omahonye/measuring-wave-forces-on-lighthouses/docs/README.md

# Documentation

This folder contains the supporting thesis, and engineering drawings for the project.

## Contents

| File | Description |
|---|---|
| `Thesis_EoghanOMahony_25230268-1.pdf` | Master's thesis describing the design, development, implementation, and validation of the experimental wave impact measurement system. |
| `01 Accelerometer Holder.pdf` | Engineering drawing of the accelerometer holder used for sensor mounting. |
| `02 Lighthouse Base Drawing.pdf` | Engineering drawing of the lighthouse base section. |
| `03 Fastnet Whole.pdf` | Complete engineering drawing of the Fastnet lighthouse model. |
| `04 Skerryvore Base Drawing.pdf` | Engineering drawing of the Skerryvore lighthouse base section. |
| `05 Skerryvore Upper Drawing.pdf` | Engineering drawing of the Skerryvore upper section. |
| `06 Ar Men Base Drawing.pdf` | Engineering drawing of the Ar Men lighthouse base section. |
| `07 Ar Men Upper Drawing.pdf` | Engineering drawing of the Ar Men upper section. |
| `08 Wolf Rock Base Drawing.pdf` | Engineering drawing of the Wolf Rock lighthouse base section. |
| `09 Wolf Rock Upper Drawing.pdf` | Engineering drawing of the Wolf Rock upper section. |

## Thesis

The thesis provides a comprehensive description of the project, including:

- Background and literature review
- System design and hardware development
- Embedded software implementation
- Python data acquisition and processing tools
- Experimental methodology
- Calibration procedures
- Results and discussion
- Conclusions and recommendations for future work

The source code, embedded firmware, and engineering drawings contained in this repository were developed as part of the work presented in the accompanying thesis.

## Engineering Drawings

The included engineering drawings document the design and manufacture of the experimental components, including:

- Accelerometer mounting hardware
- Lighthouse geometry
- Base and upper sections for:
  - Fastnet
  - Skerryvore
  - Ar Men
  - Wolf Rock

These drawings provide the dimensions and construction details required to reproduce the physical sections used during experimental validation.

## Citation

If you use or reference this work, please cite the accompanying thesis.

## Contact

For questions regarding the project, engineering drawings, or thesis, please contact the repository author through GitHub.
