omahonye/measuring-wave-forces-on-lighthouses/docs/01 Accelerometer Holder.pdf

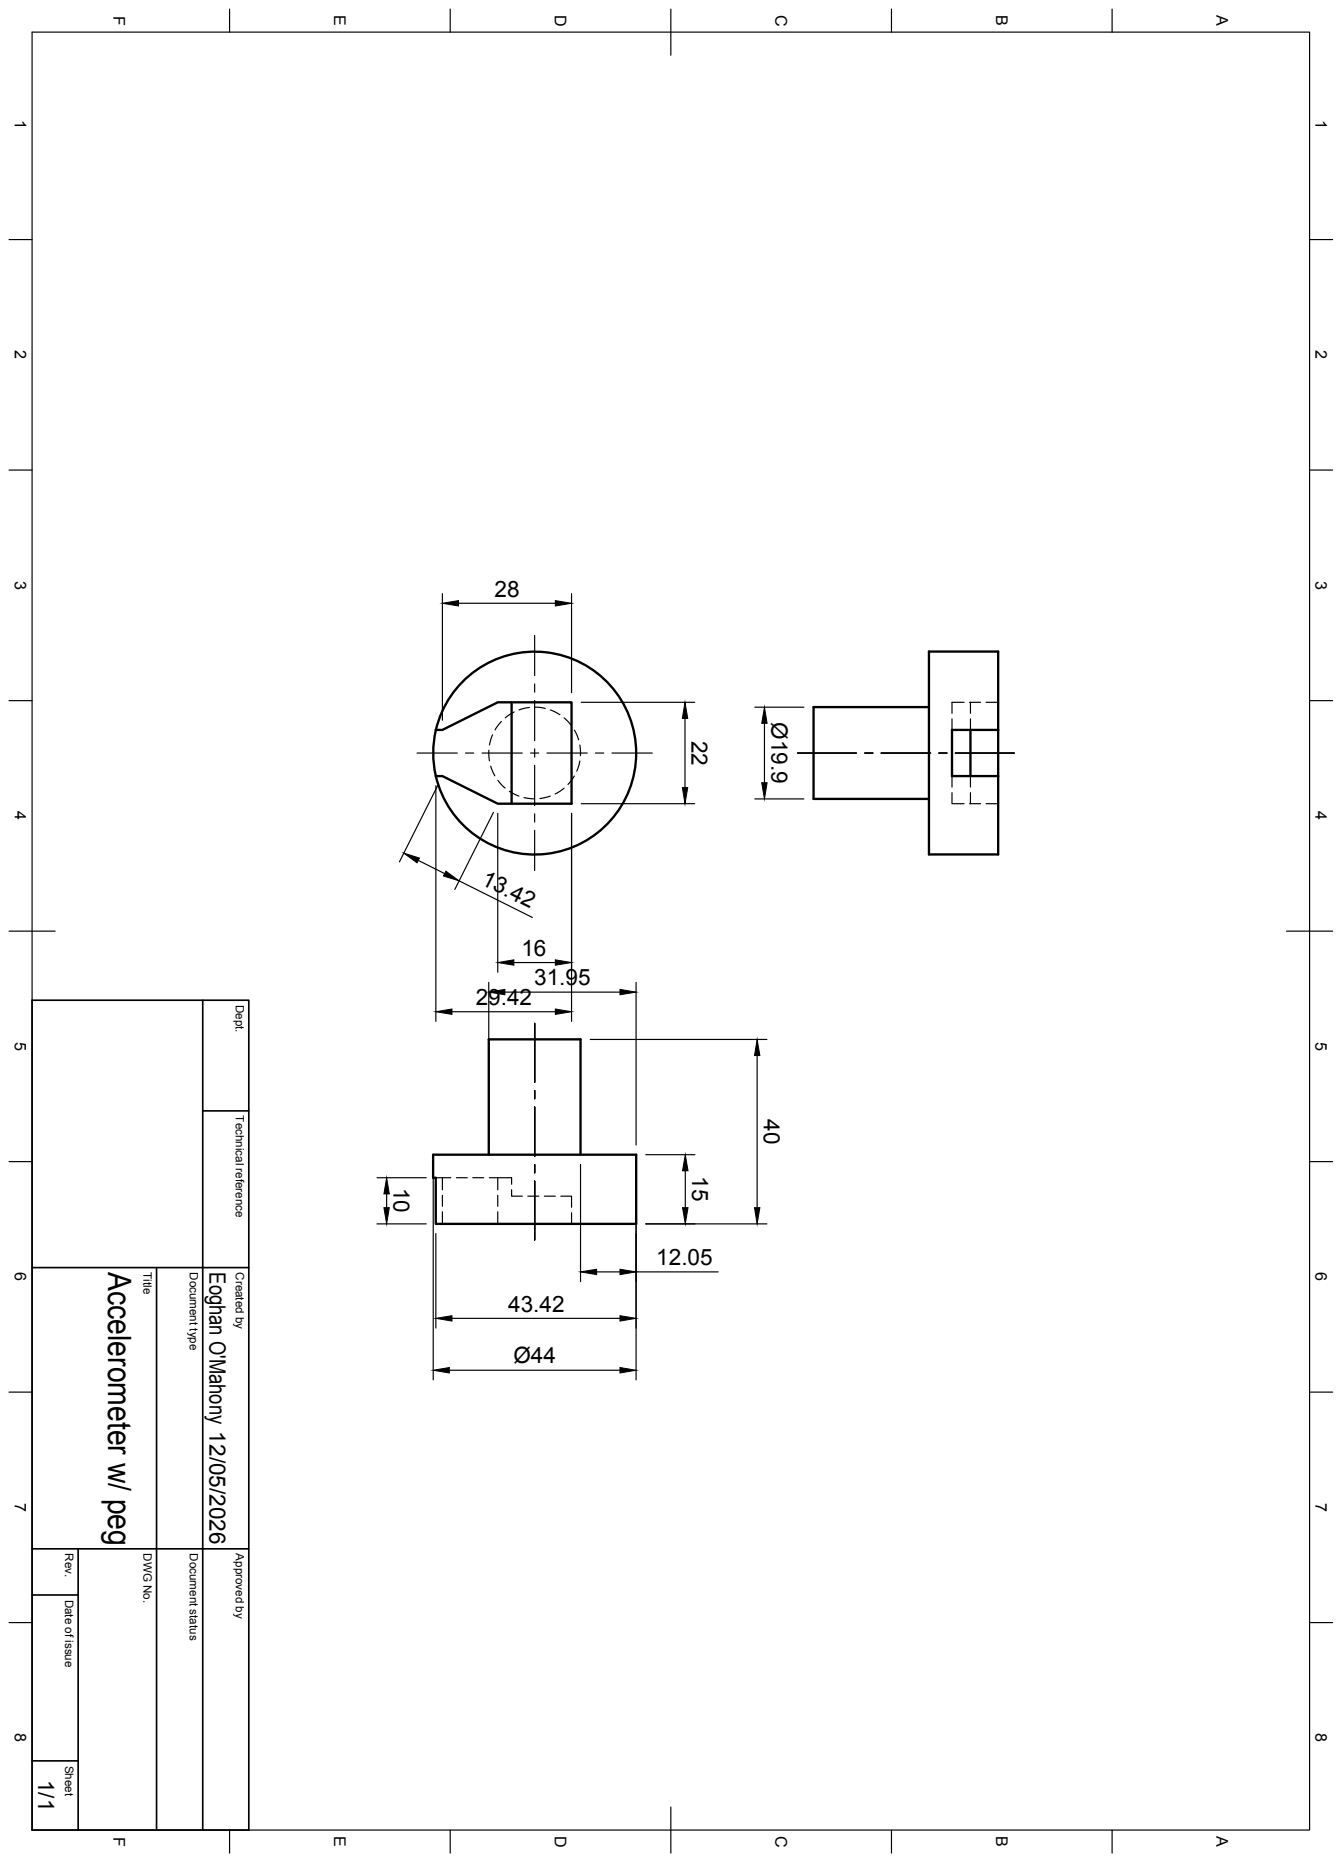
[picture p1: page 1]
DWG No.; Accelerometer w/ peg; Eoghan O'Mahony

Dept. Technical reference Created by Approved by

Document type Document status

Date of issue Sheet
