omahonye/measuring-wave-forces-on-lighthouses/docs/02 Lighthouse Base Drawing.pdf

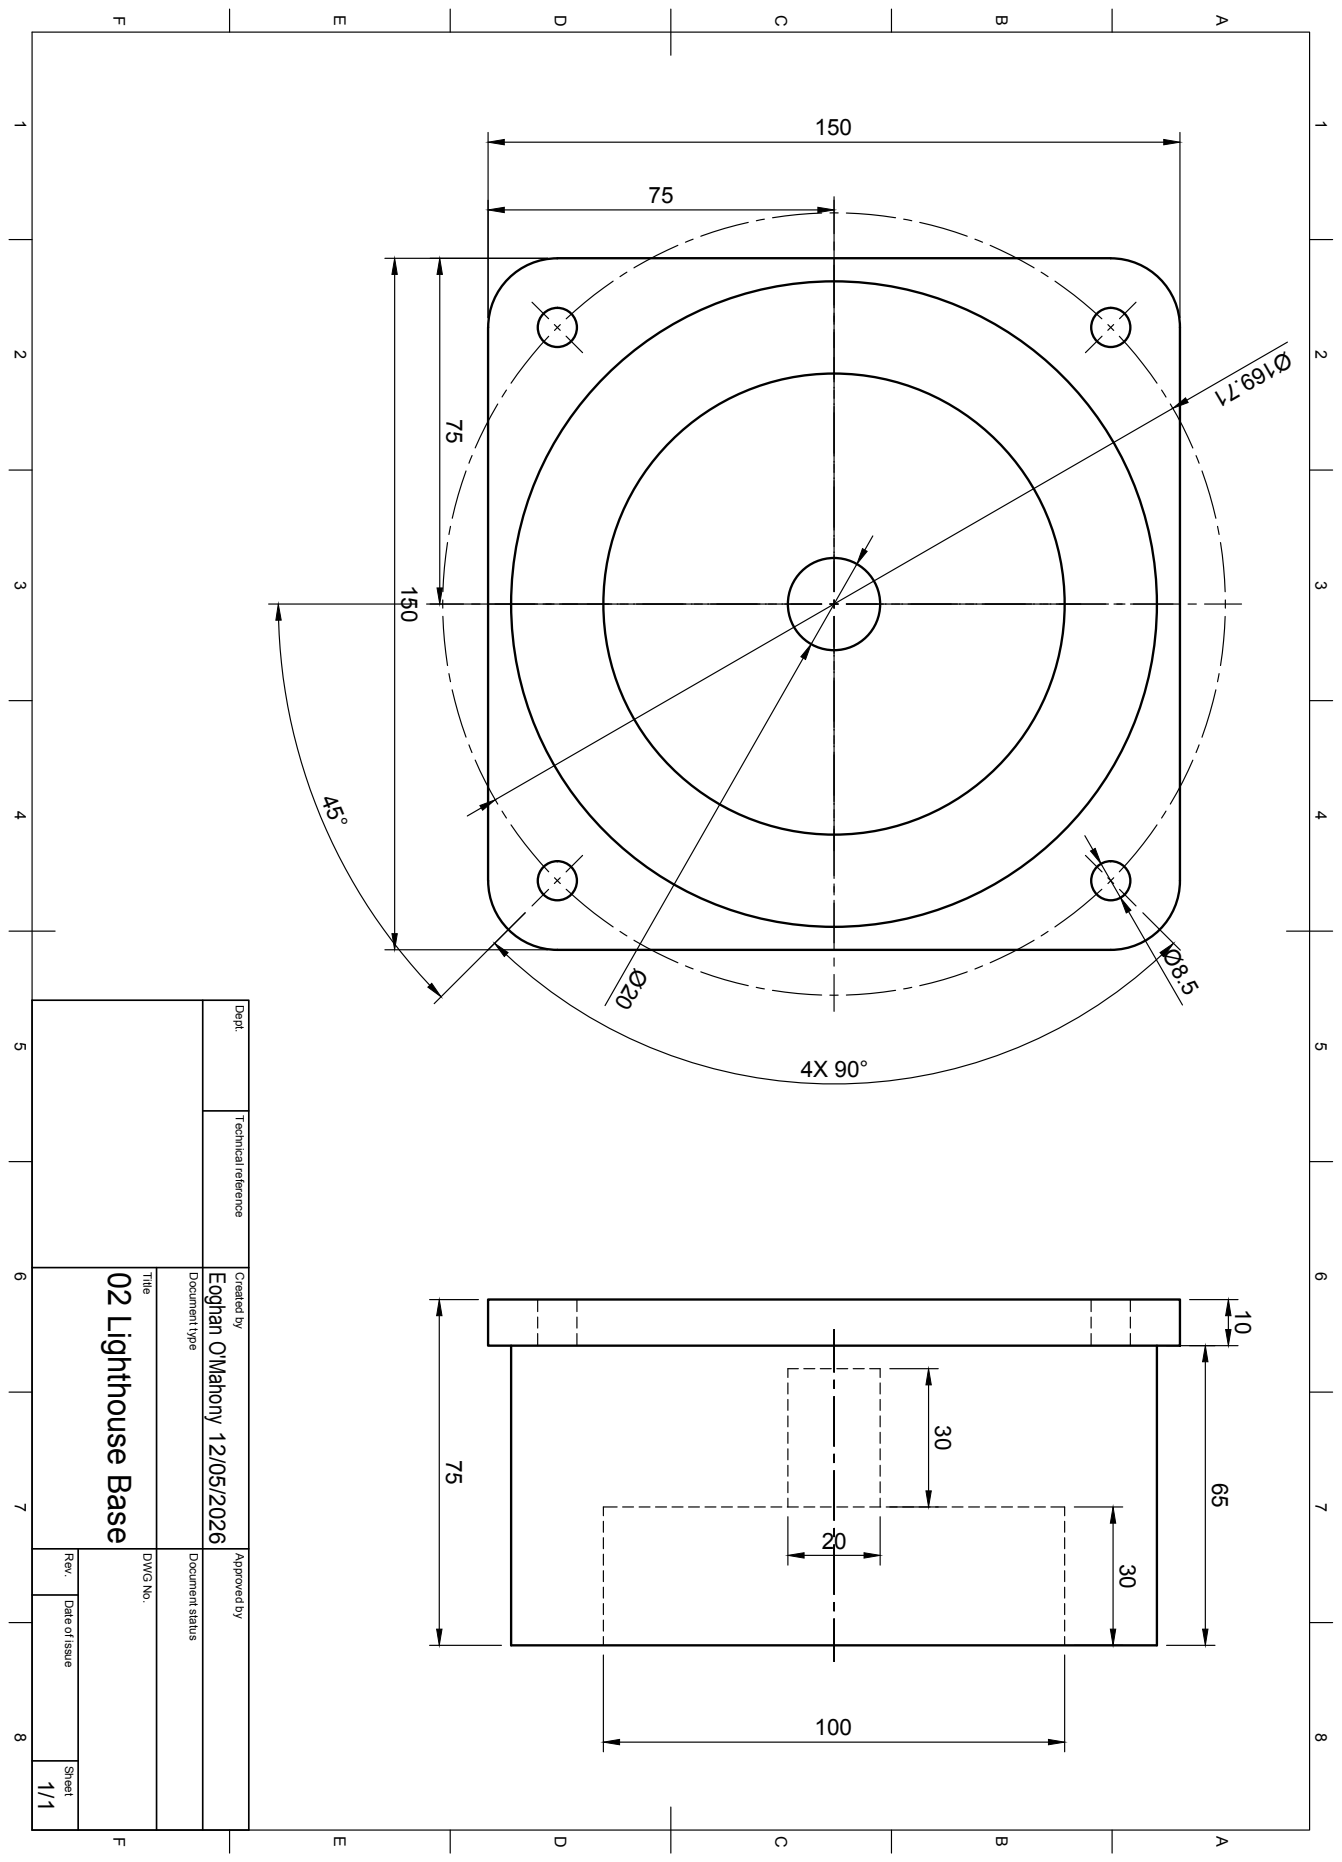
[picture p2: page 1]
DWG No.; 02 Lighthouse Base; Eoghan O'Mahony 150

Dept. Technical reference Created by Approved by

Document type Document status

Date of issue Sheet
