omahonye/measuring-wave-forces-on-lighthouses/docs/03 Fastnet Whole.pdf

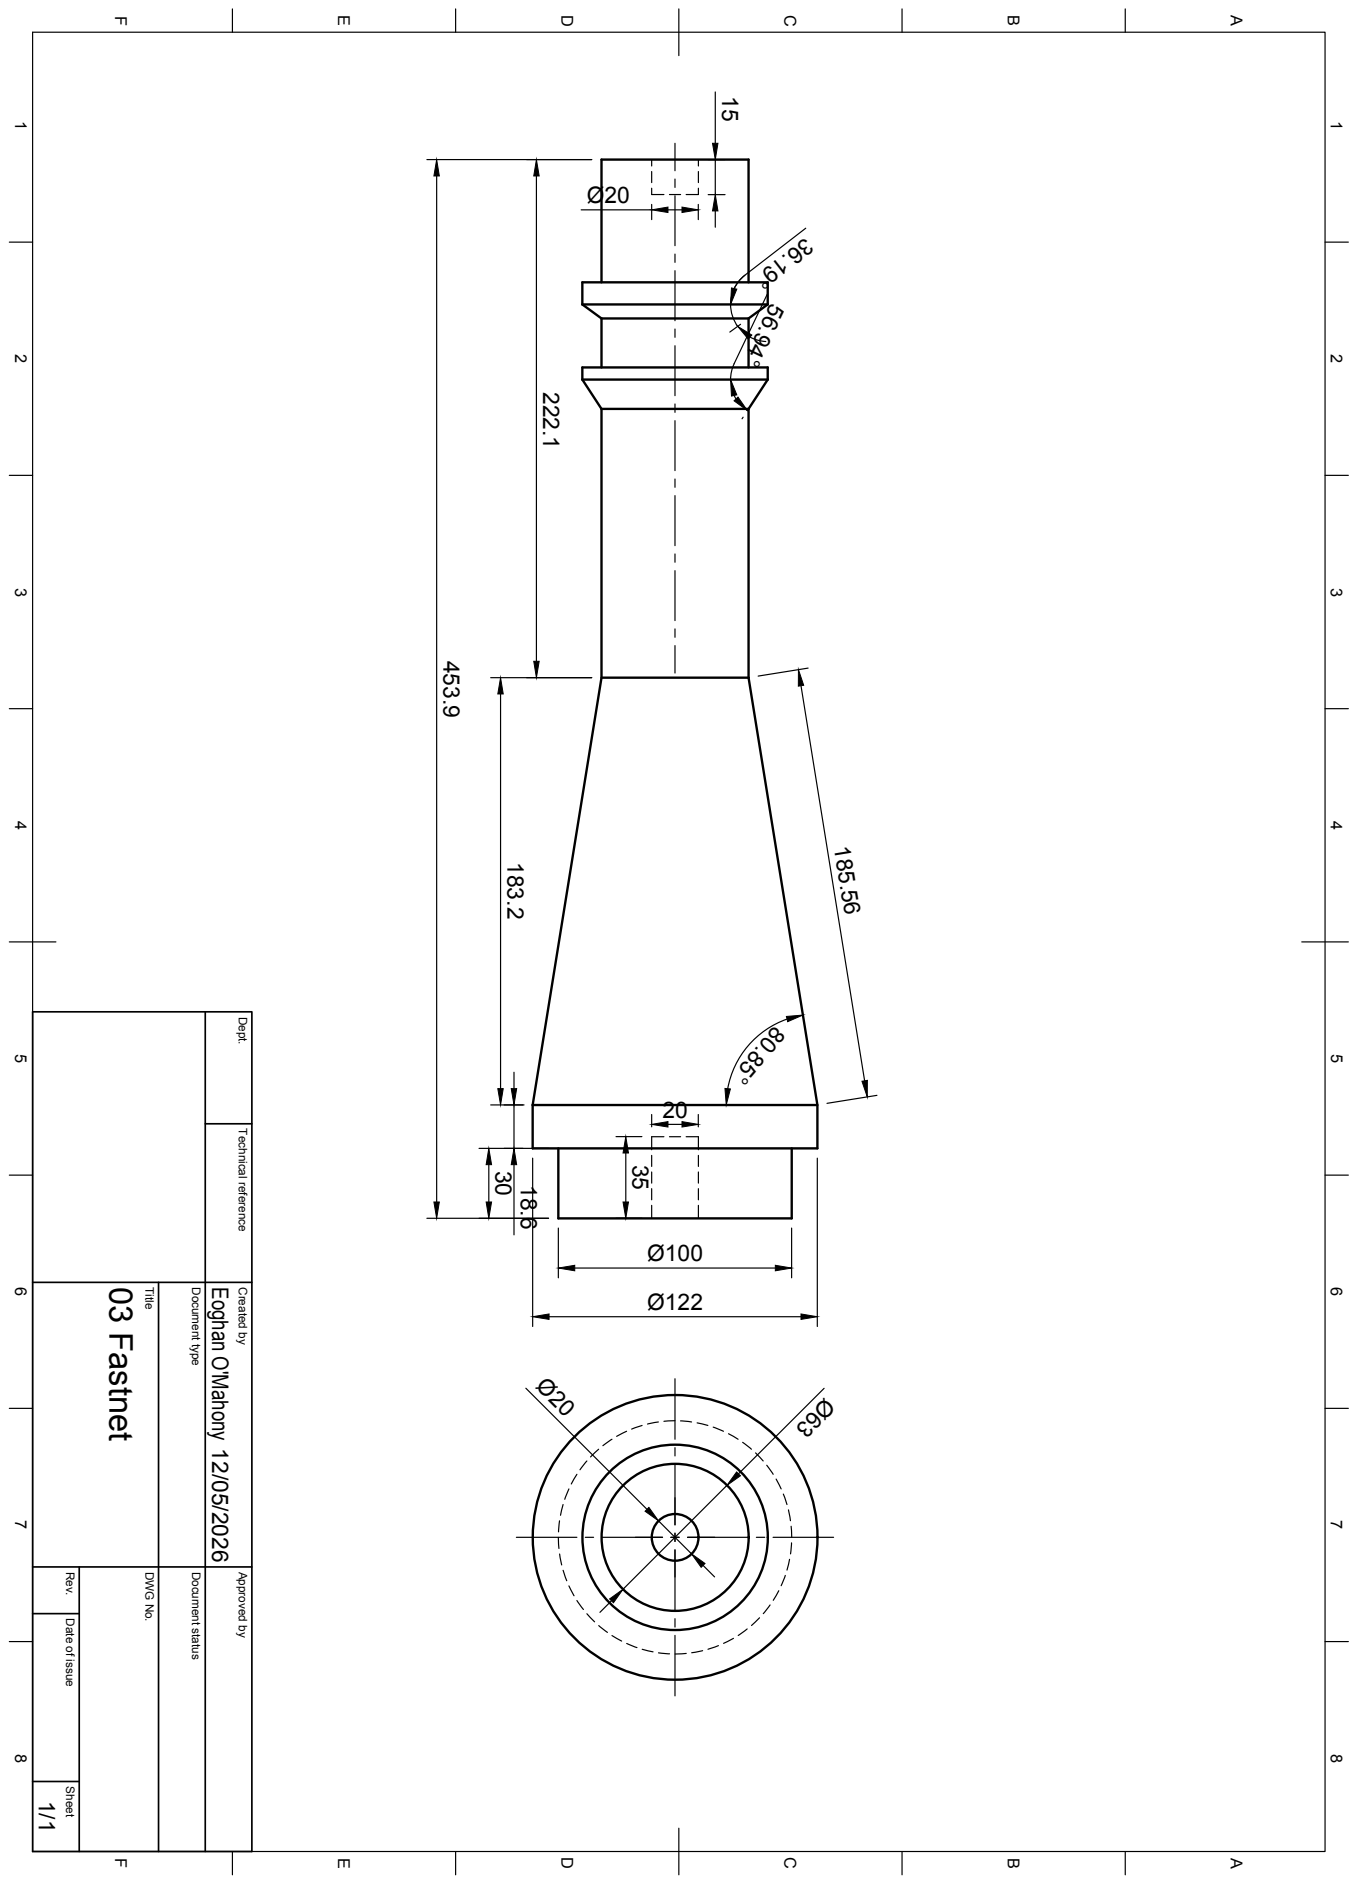
[picture p3: page 1]
DWG No.; 03 Fastnet; Eoghan O'Mahony Ø122

Dept. Technical reference Created by Approved by

Document type Document status

Date of issue Sheet
