omahonye/measuring-wave-forces-on-lighthouses/docs/04 Skerryvore Base Drawing.pdf

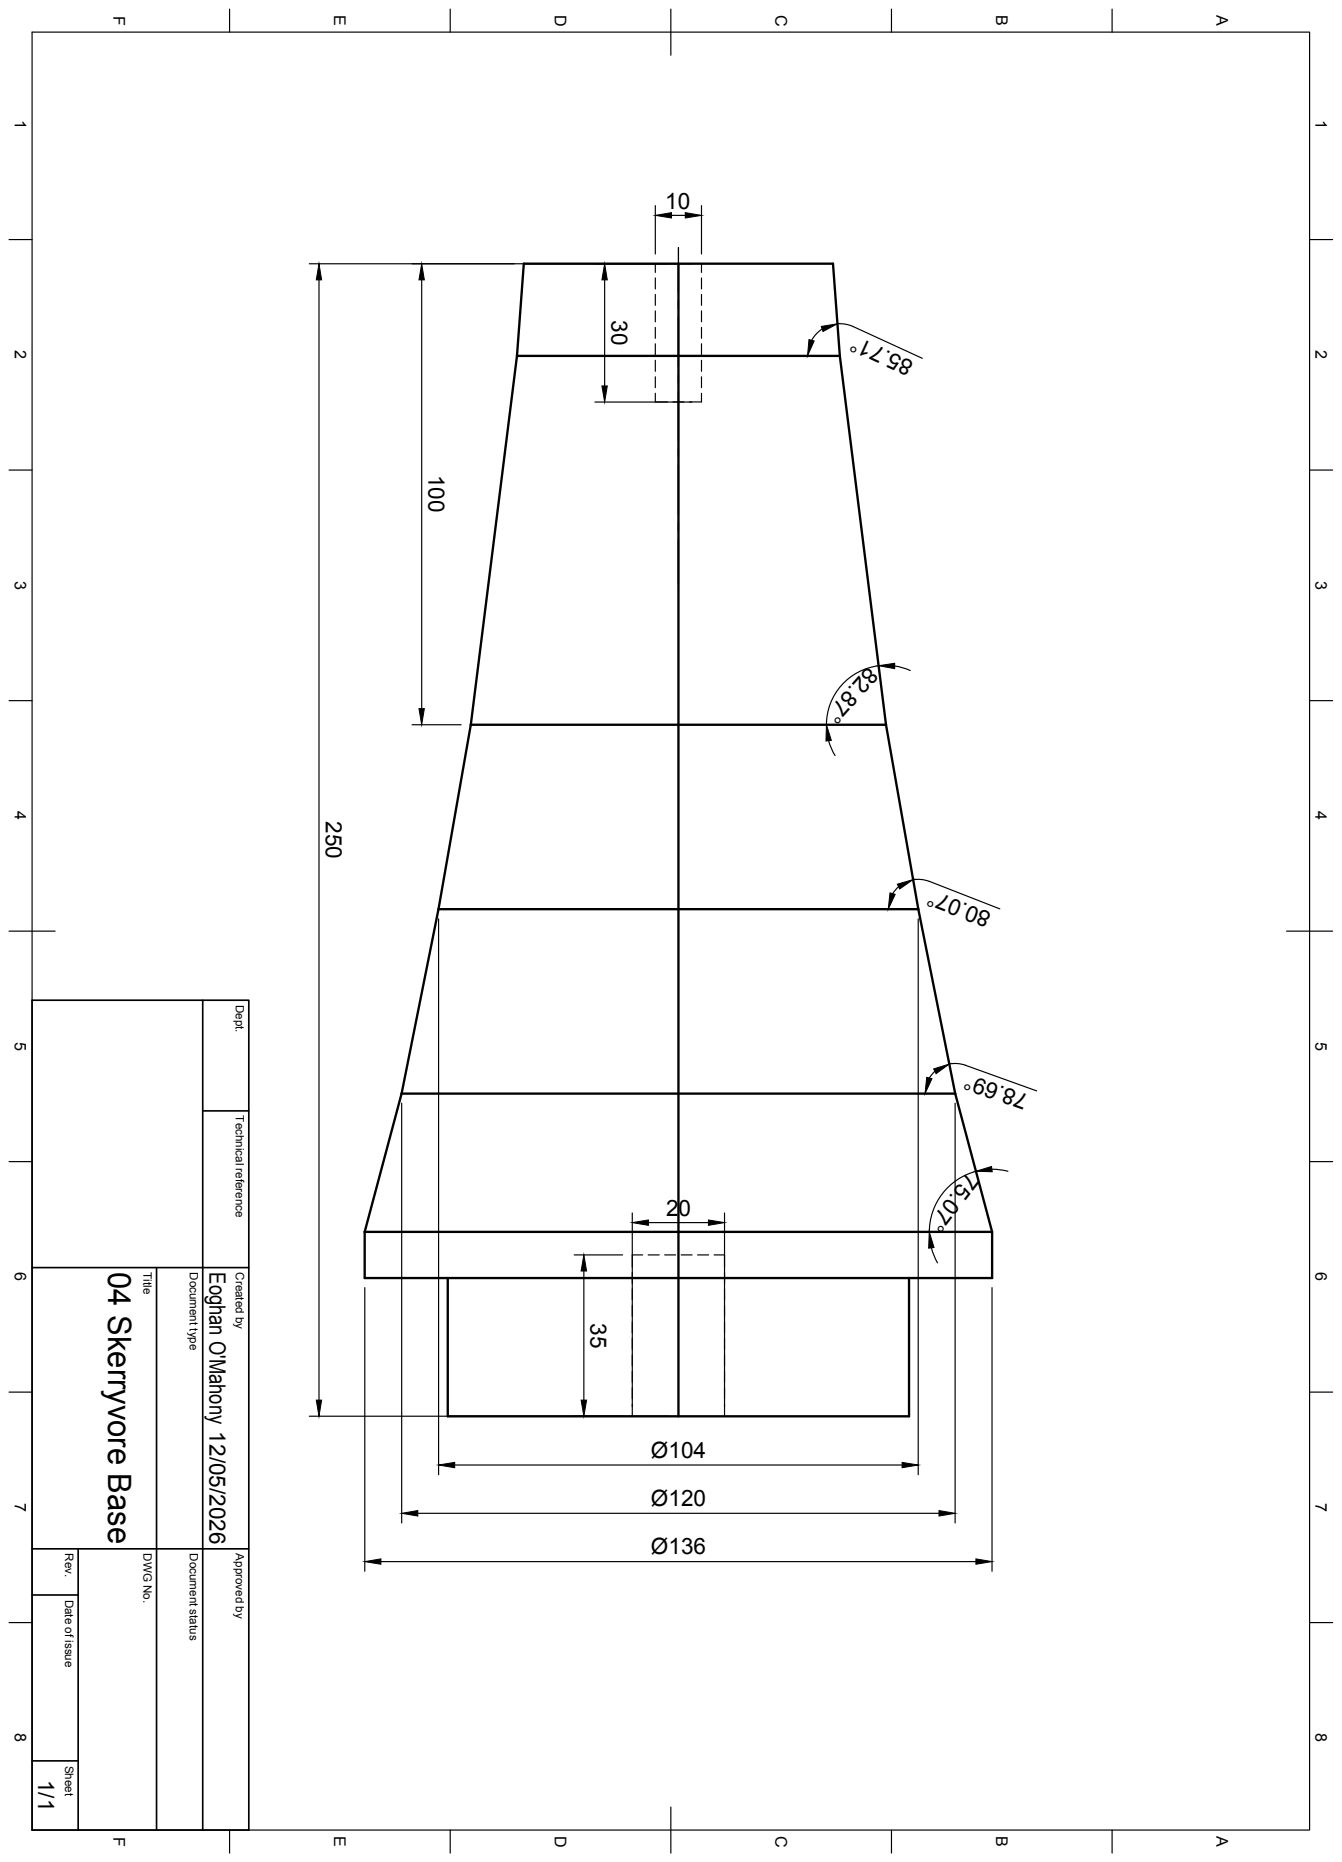
[picture p4: page 1]
DWG No.; 04 Skerryvore Base; Eoghan O'Mahony

Dept. Technical reference Created by Approved by

Document type Document status

Date of issue Sheet
