omahonye/measuring-wave-forces-on-lighthouses/docs/05 Skerryvore Upper Drawing.pdf

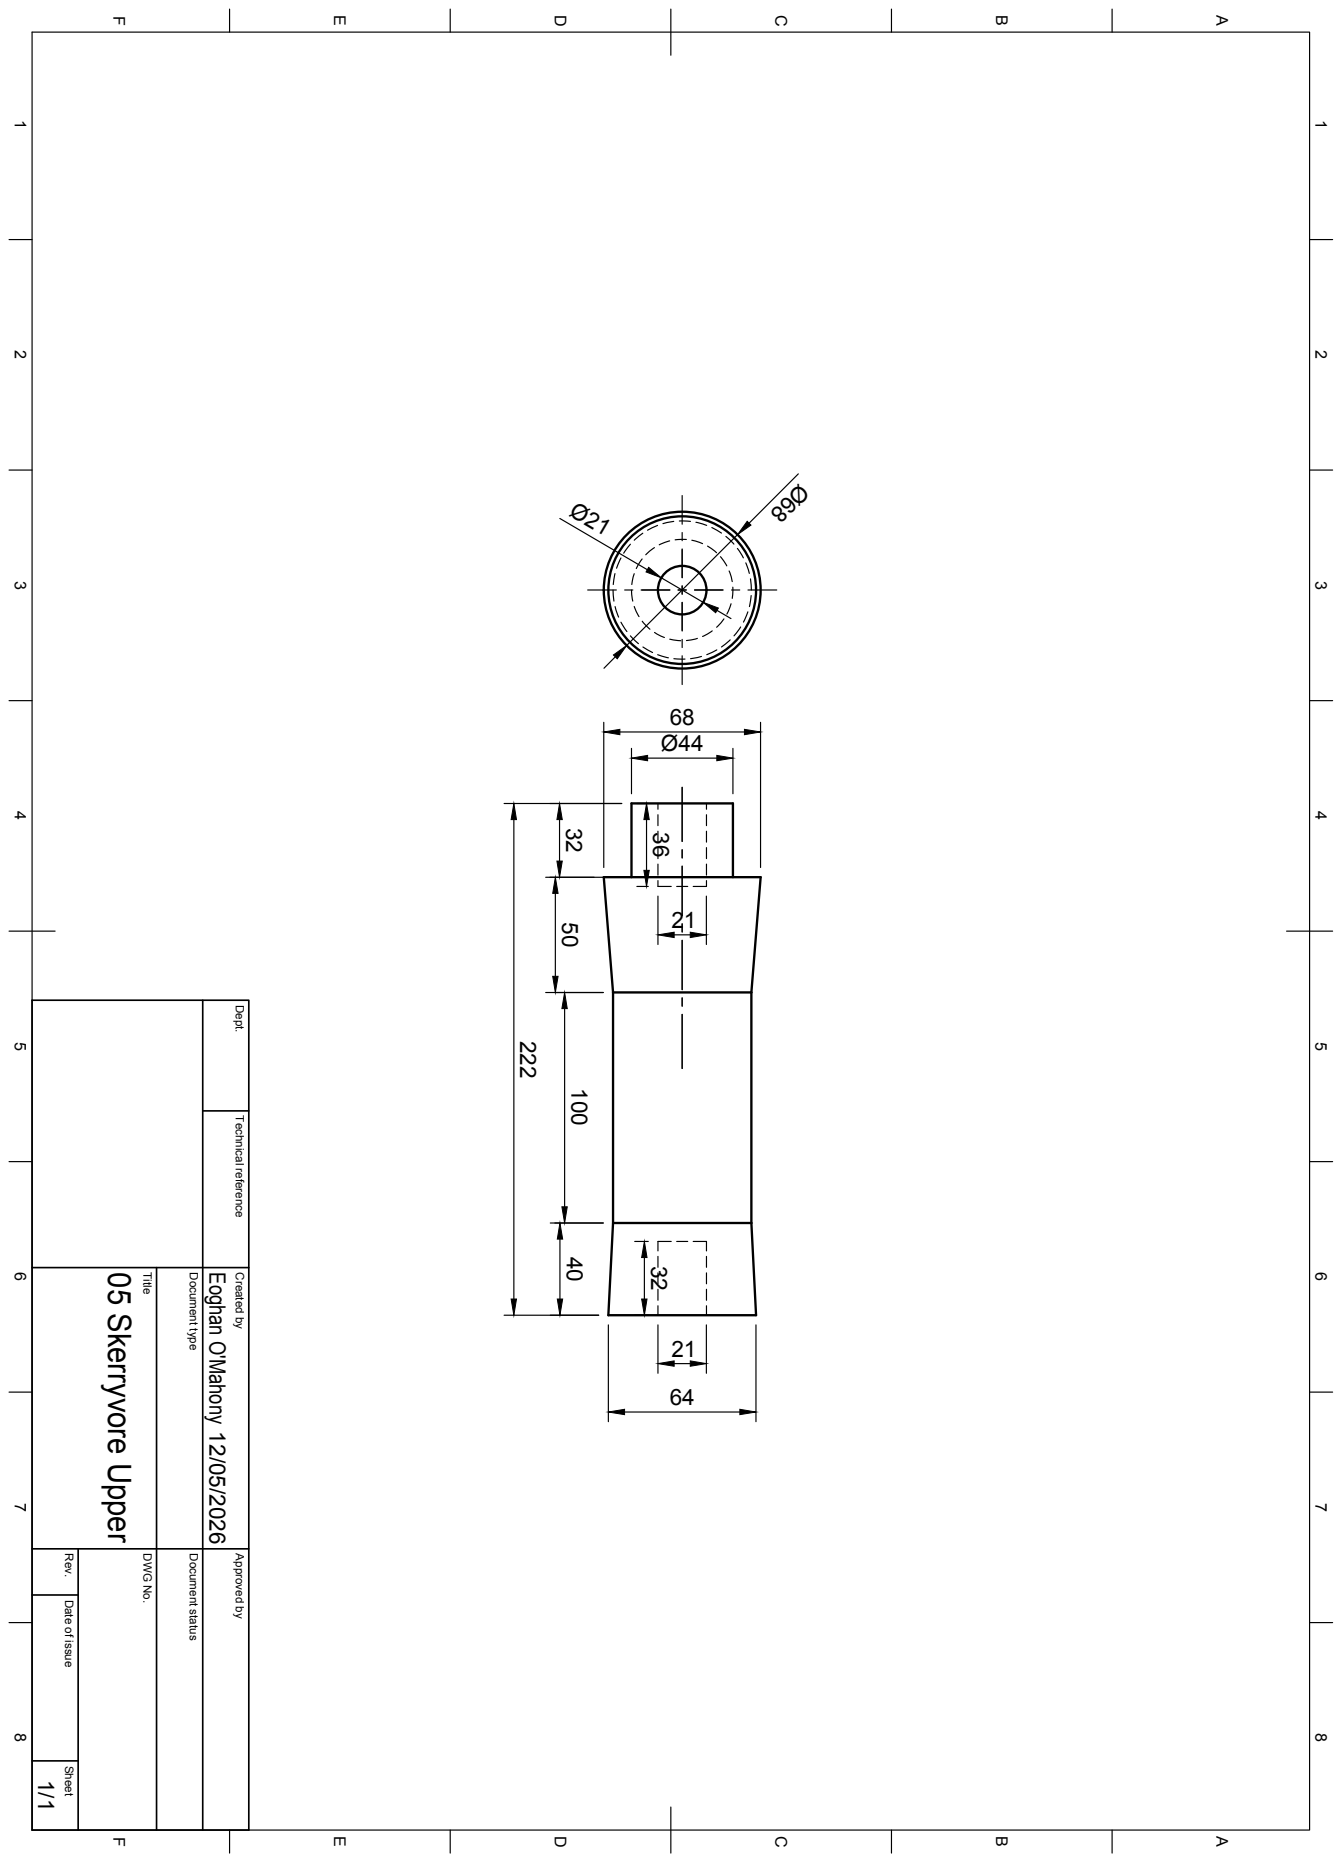
[picture p5: page 1]
DWG No.; 05 Skerryvore Upper; Eoghan O'Mahony

Dept. Technical reference Created by Approved by

Document type Document status

Date of issue Sheet
