omahonye/measuring-wave-forces-on-lighthouses/docs/06 Ar Men Base Drawing.pdf

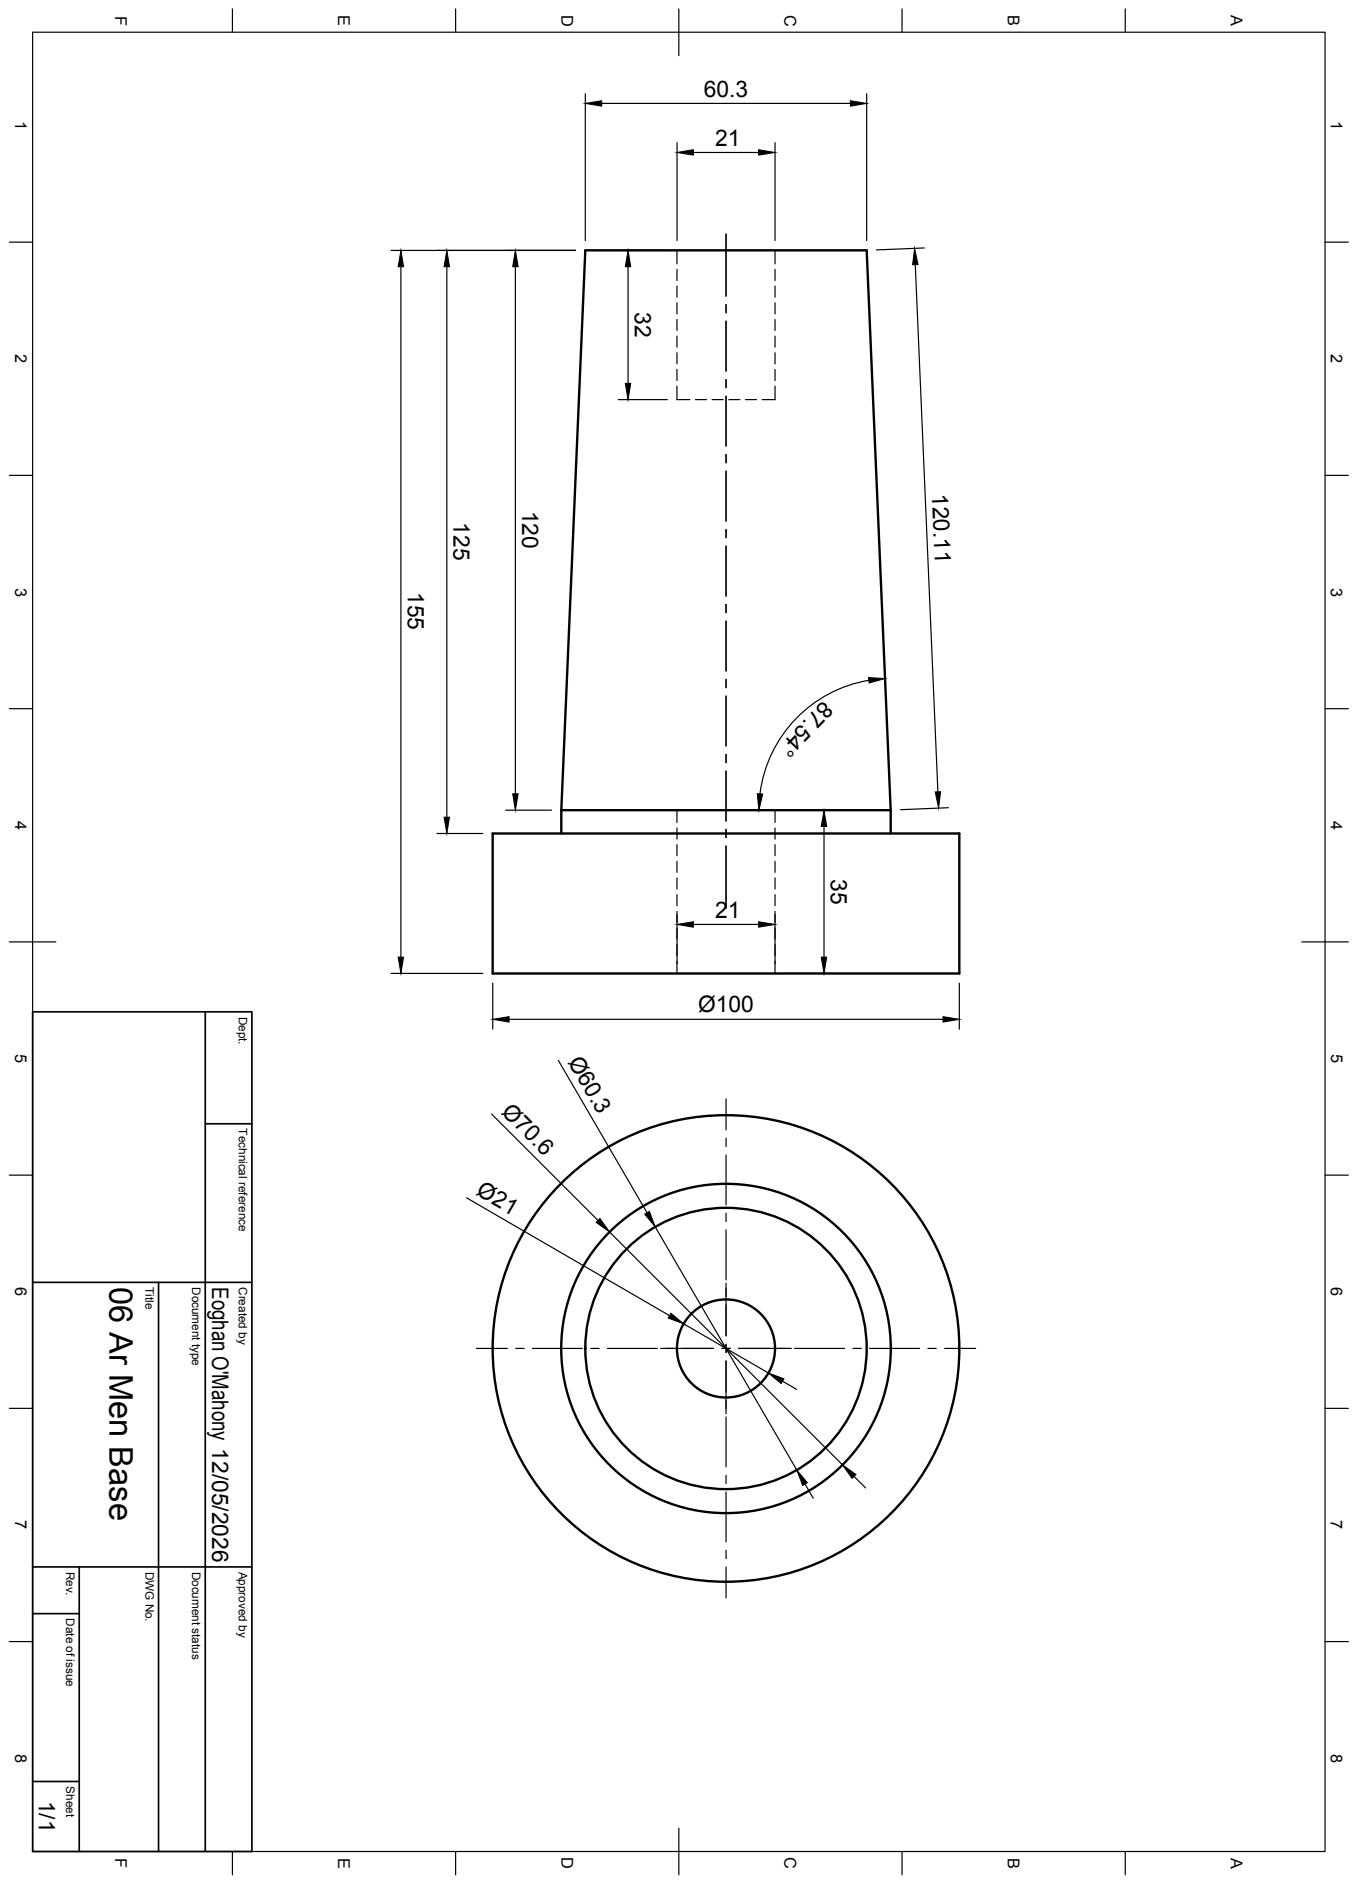
[picture p6: page 1]
DWG No.; Eoghan O'Mahony Ø100

Dept. Technical reference Created by Approved by

06 Ar Men Base

Document type Document status

Date of issue Sheet
