omahonye/measuring-wave-forces-on-lighthouses/docs/07 Ar Men Upper Drawing.pdf

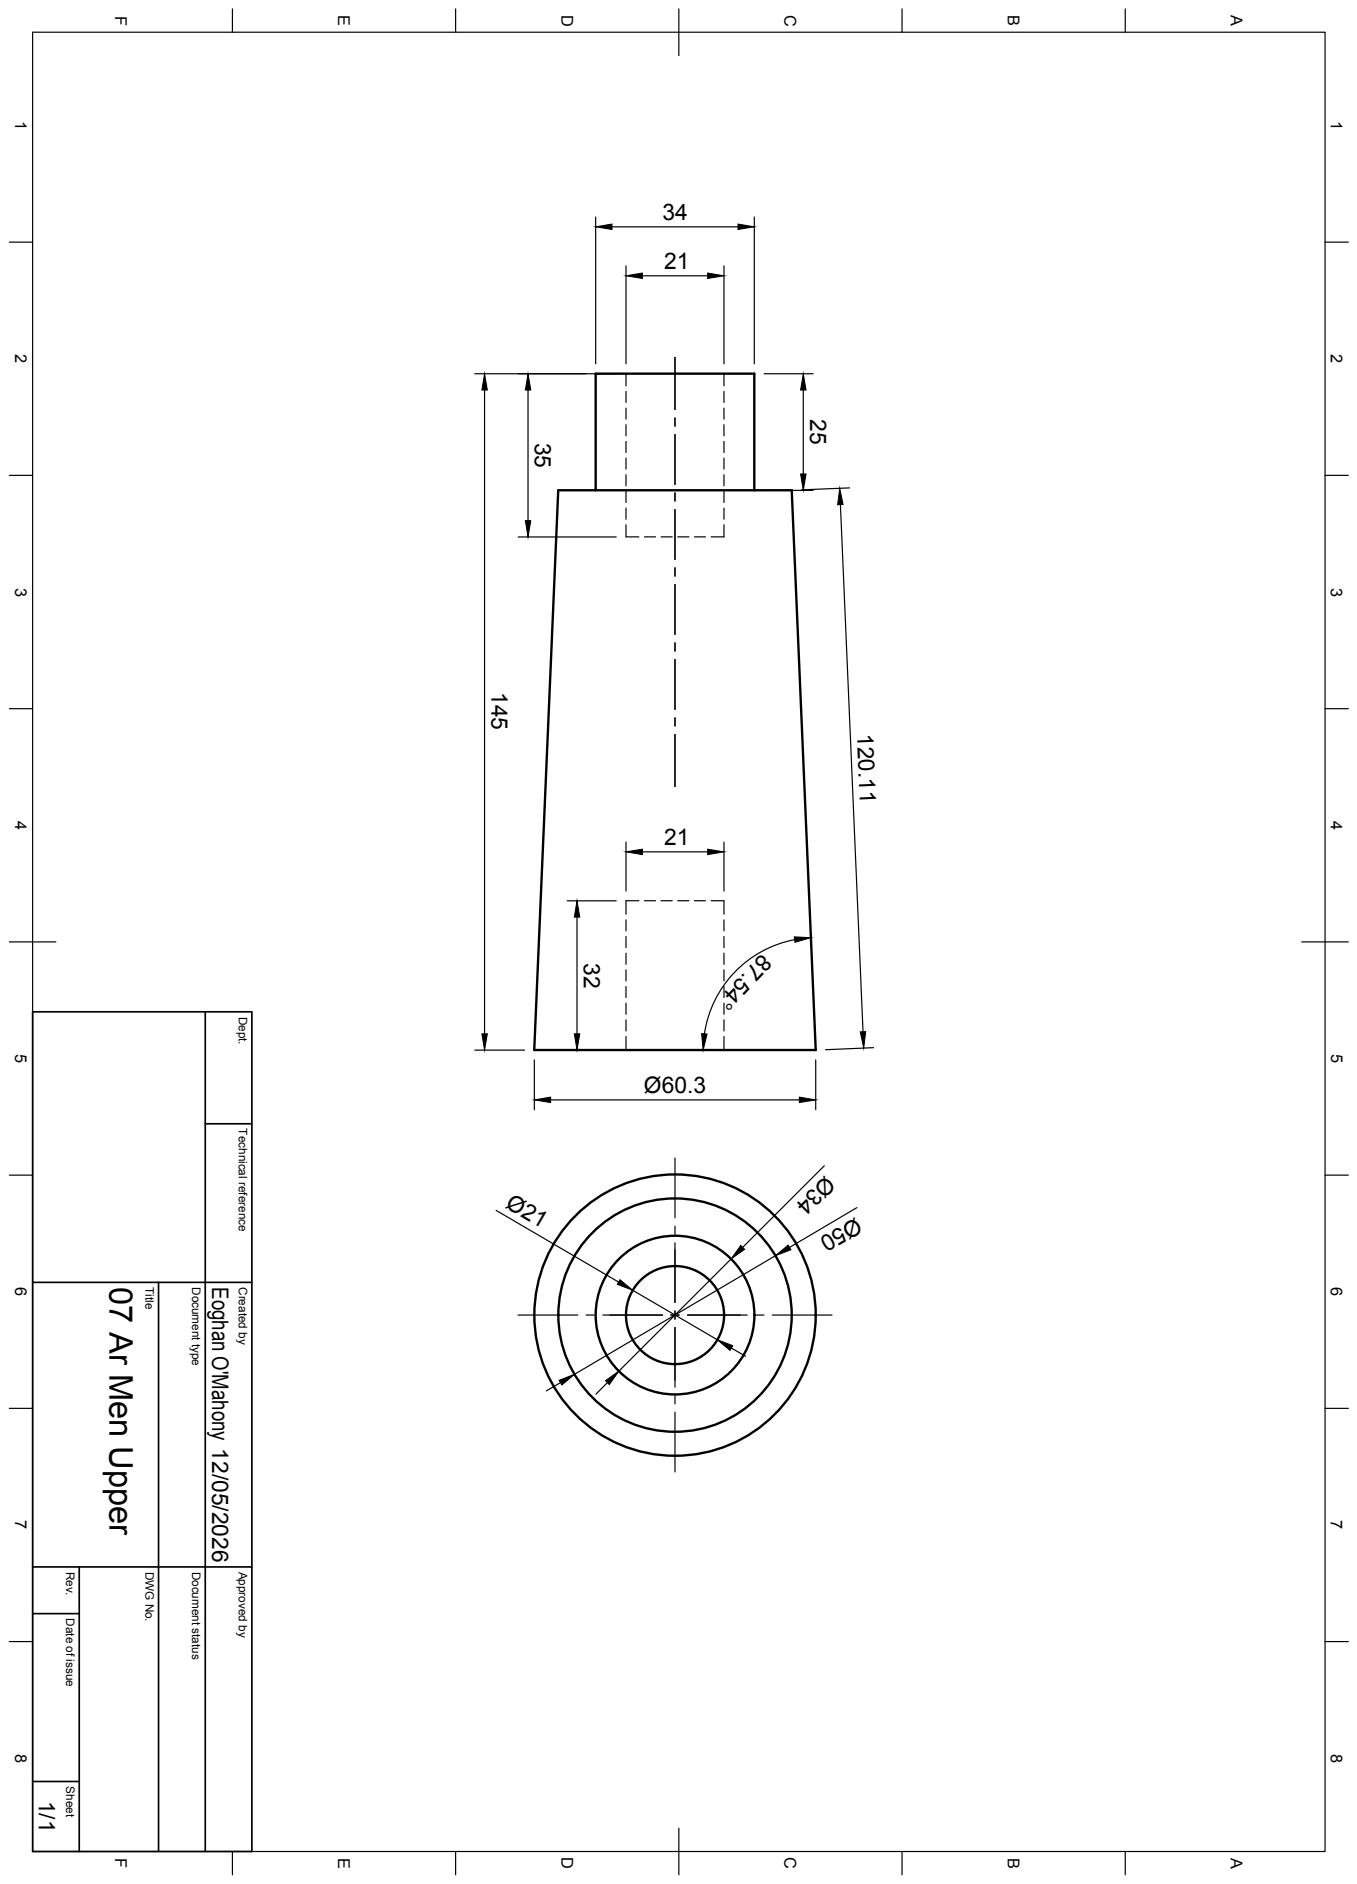
[picture p7: page 1]
DWG No.; Eoghan O'Mahony Ø60.3

Dept. Technical reference Created by Approved by

07 Ar Men Upper

Document type Document status

Date of issue Sheet
