omahonye/measuring-wave-forces-on-lighthouses/docs/08 Wolf Rock Base Drawing.pdf

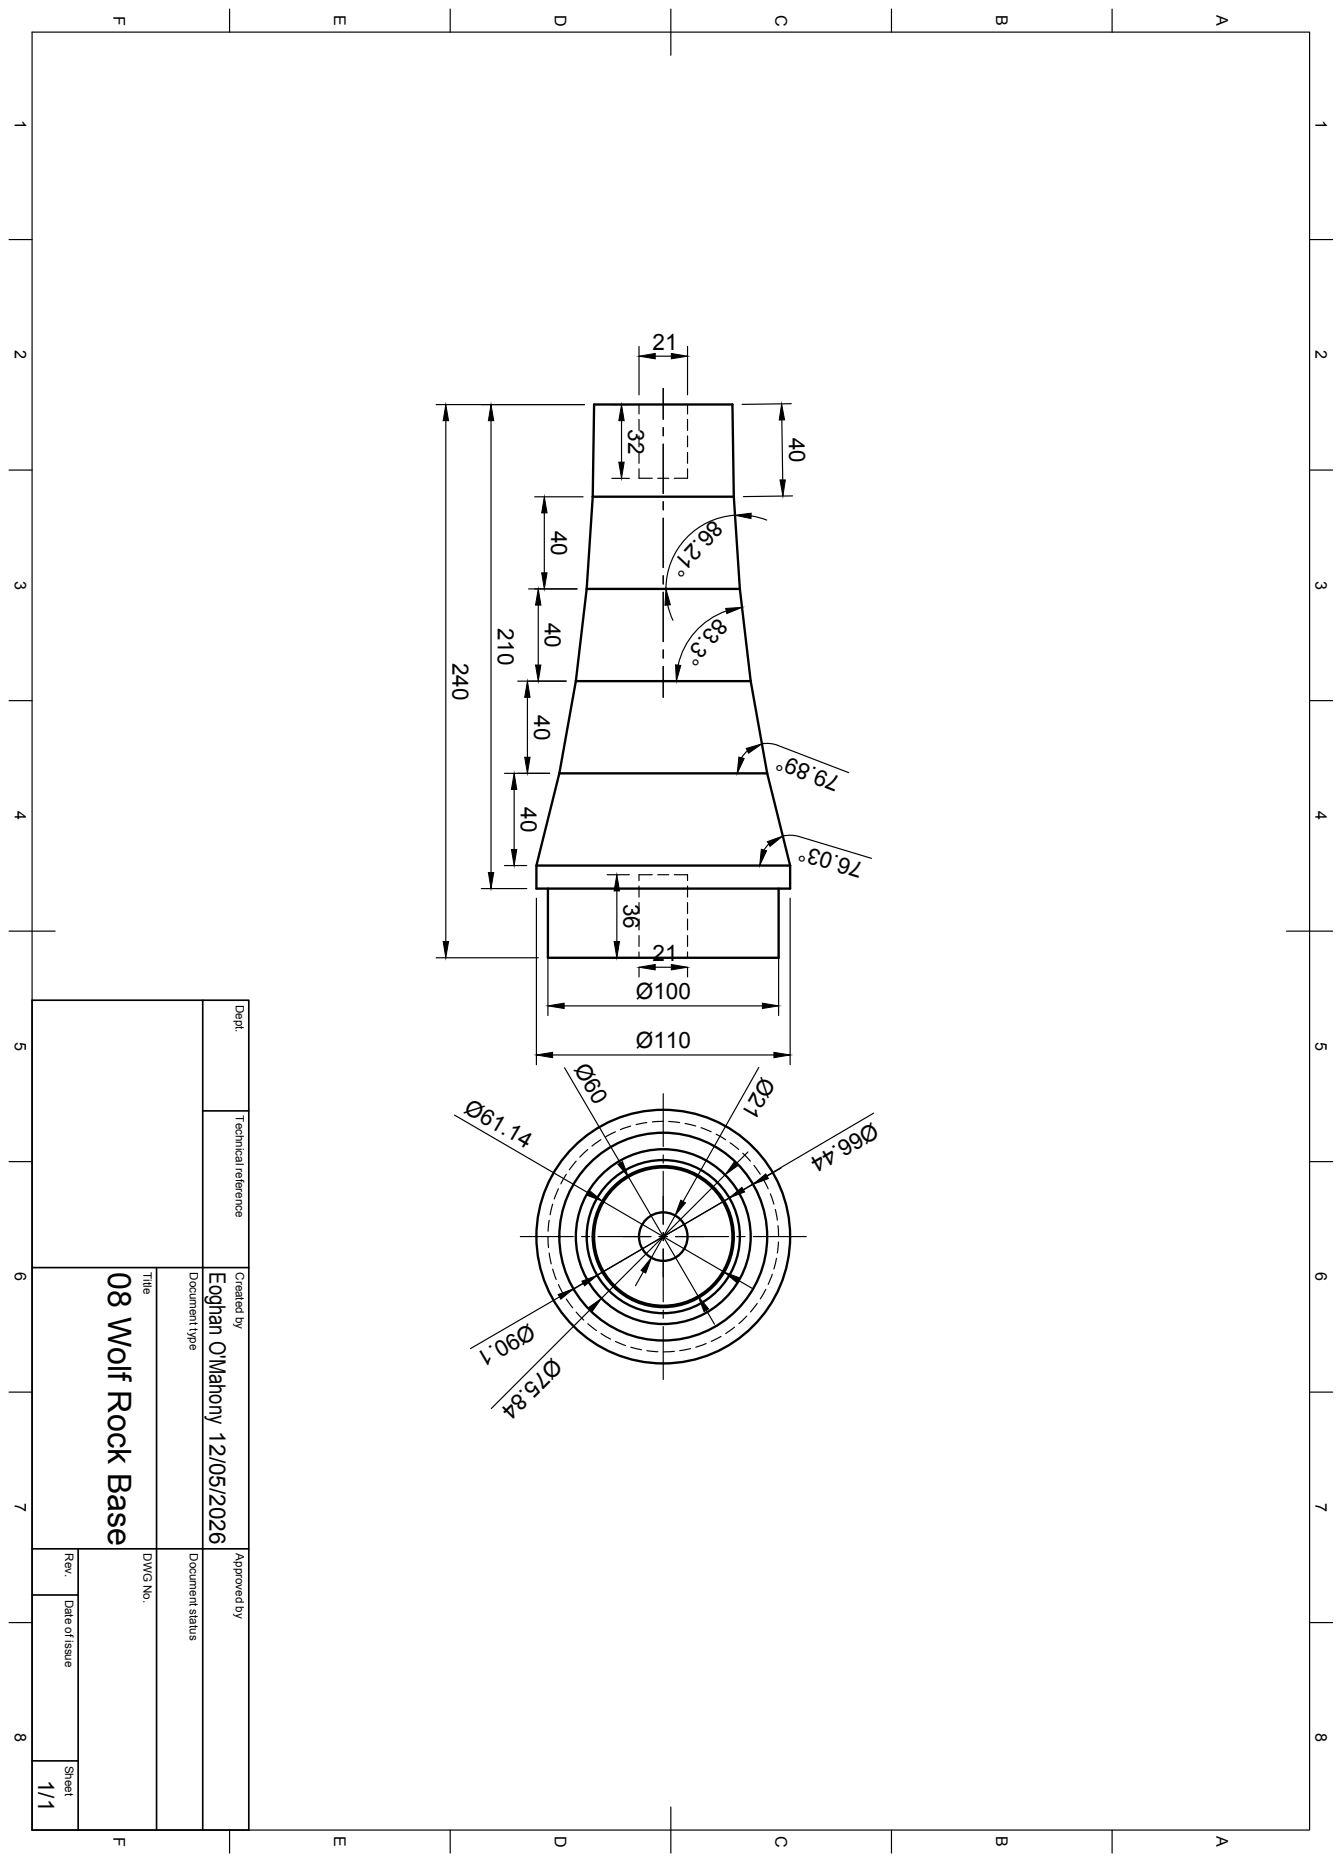
[picture p8: page 1]
DWG No.; Eoghan O'Mahony Ø110

Dept. Technical reference Created by Approved by

08 Wolf Rock Base

Document type Document status

Date of issue Sheet
