omahonye/measuring-wave-forces-on-lighthouses/docs/09 Wolf Rock Upper Drawing.pdf

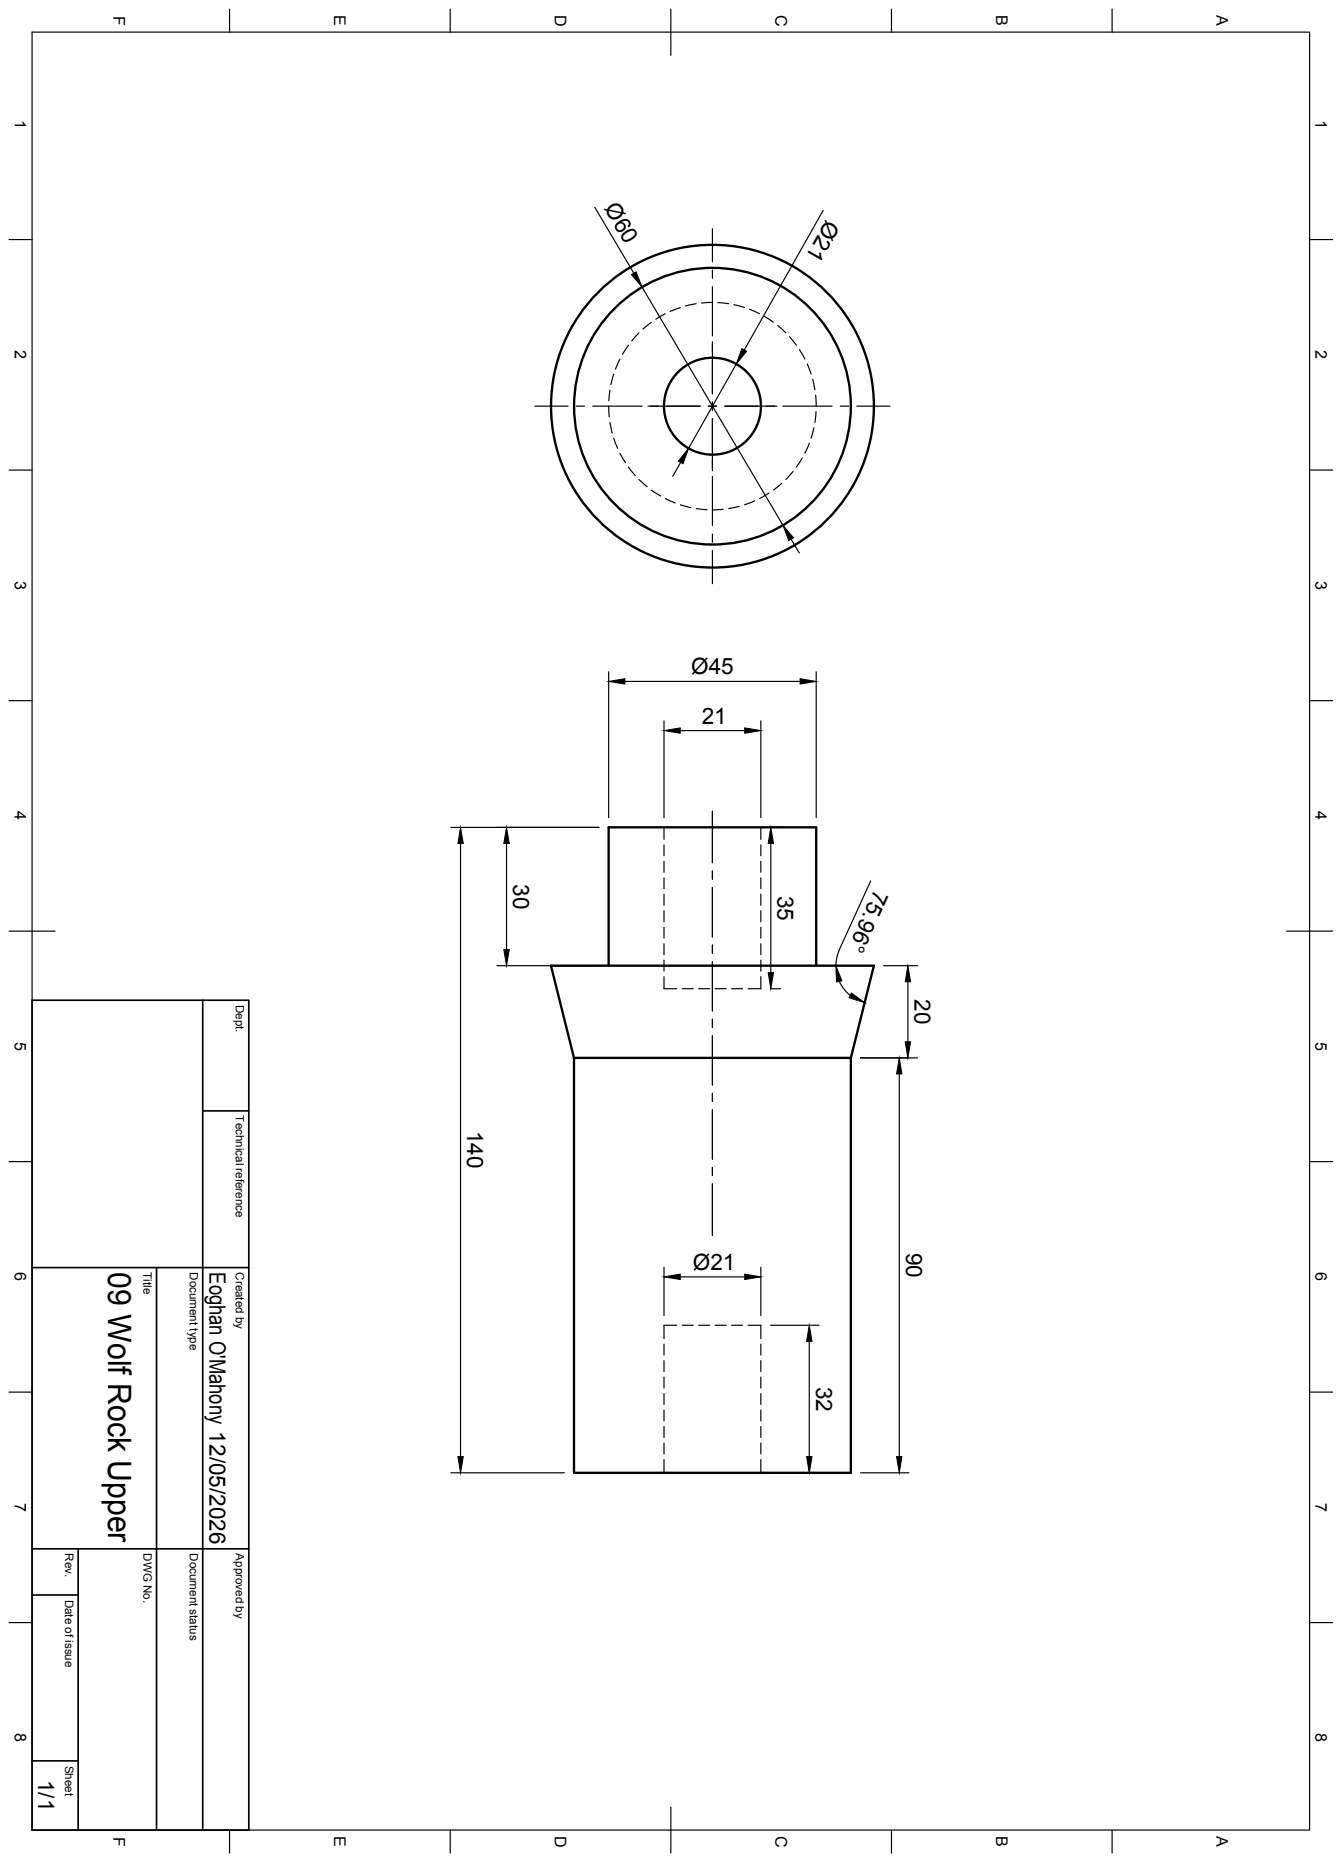
[picture p9: page 1]
DWG No.; Eoghan O'Mahony

Dept. Technical reference Created by Approved by

09 Wolf Rock Upper

Document type Document status

Date of issue Sheet
